GoTouchGra55/Phaze/README.md

# Phaze
A field-oriented control board designed to be used with a brushless motor.

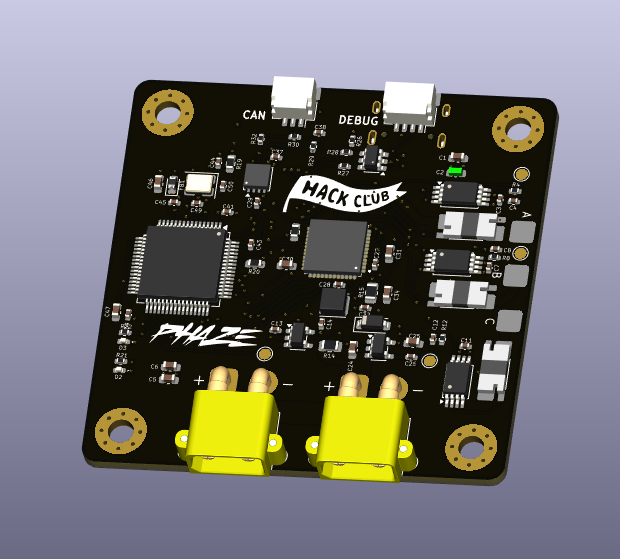
[picture p1: Assets/PCB.png]
PCB


## Overview
Phaze is my attempt at making a custom FOC driver. It utilizes the CAN protocol for communication between a main board and the driver, but it can also be programmed directly via an STLink-V2 debugger. 

The main goal of this project was to explore the hardware side of field-oriented control, especially the design of a dedicated motor driver and the electronics required to control a bldc motor. I wanted to design my own board and understand how all the different sections work together, rather than relying on any existing motor controllers.

## Design
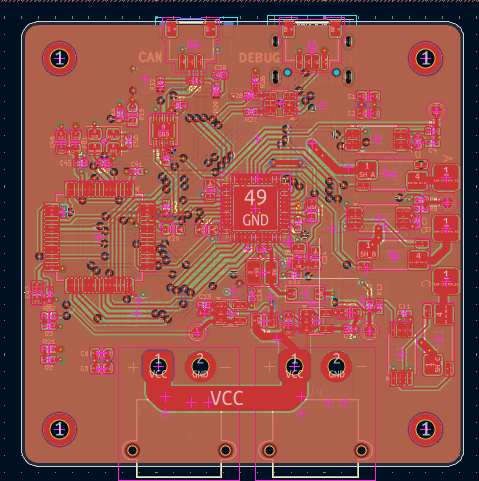
[picture p2: Assets/Routing.png]
Routing
 
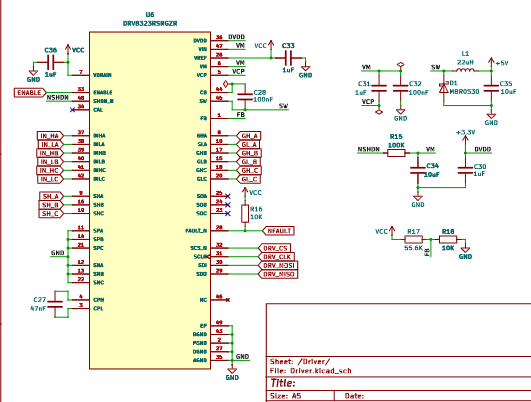
[picture p3: Assets/SCH.png]
Schematics
    
SEE [SCHEMATICS](KiCAD/Phaze.pdf)

## Build Instructions
1. Order the PCB using the provided [files](KiCAD/production).
2. Solder all SMD components according to the schematic and PCB layout.
3. Inspect all solder joints and check for shorts.
4. Connect the peripherals according to the schematic.
5. Flash the firmware and verify all interfaces.
6. Test the power rails before connecting the motors.

## IMPORTANT
1. Use a 3-4s LiPo battery if you decide to use this board in your project. Discard the battery if it smells "funny".

2. Check for any damage on the pcb as it can be the reason for a catastrophic failure.

## Bill Of Materials
| # | Component / Item | Specifications | Qty. | Price (USD) | Link |
|---:|---|---|---:|---:|---:|
| 1 | SMD Resistor Assortment | 660 pcs, mixed packages and values | 1  | $0 | [Daraz](https://www.daraz.com.np/products/000000pcs-040222-10hm-910k-ohm-5-80llasex-cp0pcs-u003d-4000pcs-i416649373-s1793309546.html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) |
| 2 | SMD Ceramic Capacitor Assortment | 2,500 pcs, 50 values, mixed packages | 1  | $0 | [Daraz](https://www.daraz.com.np/products/2500pcs-50-values-capacitor-smd-0402-0603-0805-smd-ceramic-capacitors-assortment-kit-1p-10uf-1pf-5pf-10pf-100pf-1nf-102-333-474-i15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) |
| 3 | JLCPCB PCB Fabrication & Assembly | PCB manufacturing and assembly order | 1 order | $241.02 | [JLCPCB](https://jlcpcb.com)
| | **GRAND TOTAL** | | | **$241.02** | |

## License
### MIT License - See [LICENSE](LICENSE)

## Author
### Shaurya Tamang  
Contact: [Email](shauryatamang.dev@gmail.com)
