GoTouchGra55/Phaze/Assets/JLCPCB.png

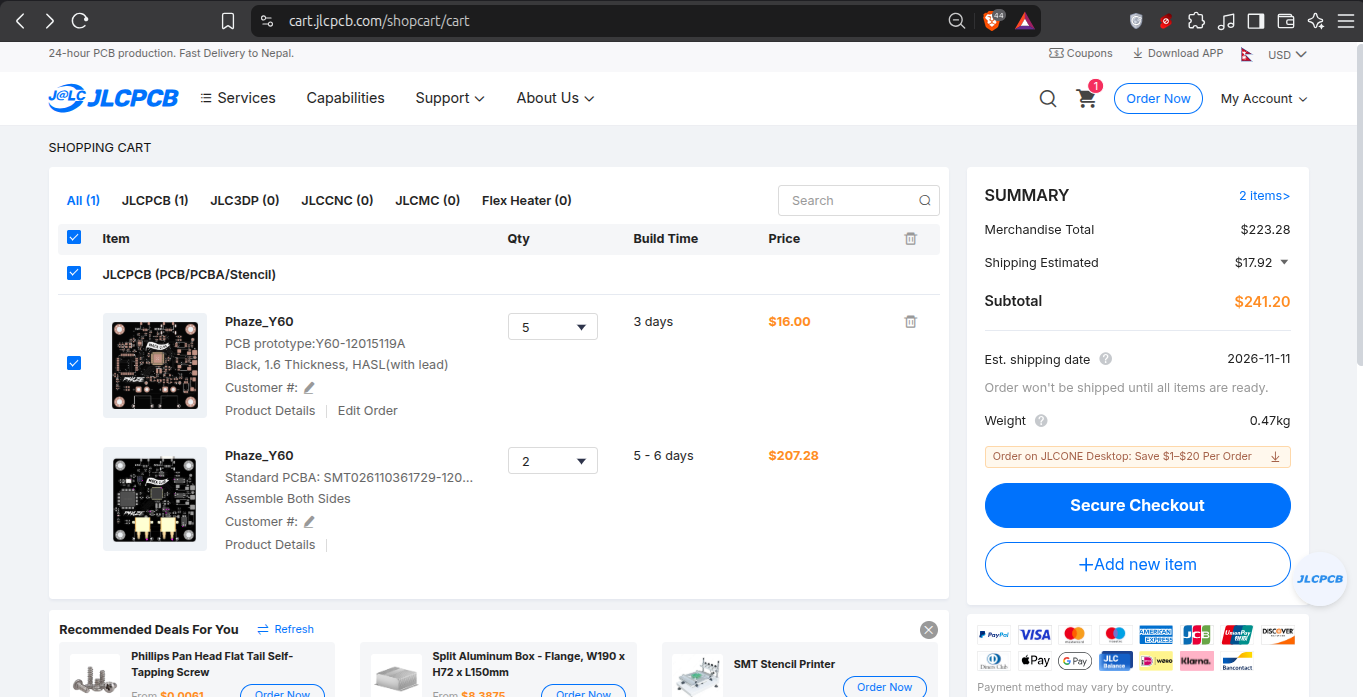
Assets/JLCPCB.png
