GoTouchGra55/Phaze/KiCAD/production/bom.csv

Designator | Footprint | Quantity | Value | LCSC Part #
C1, C10, C15, C16, C17, C18, C19, C2, C20, C21, C22, C34, C35, C5, C6, C9 | 0603 | 16 | 10uF
C11, C13, C14, C23, C28, C29, C3, C32, C37, C39, C40, C41, C42, C43, C51, C7 | 0402 | 16 | 100nF
C12, C4, C8 | 0402 | 3 | 1nF
C24, C30, C31, C33, C36 | 0603 | 5 | 1uF
C25 | 0603 | 1 | 2.2uF
C26 | 0402 | 1 | 10nF
C27 | 0402 | 1 | 47nF
C38 | 0402 | 1 | 4.7nF
C44, C45 | 0402 | 2 | 100nF | C1525
C46 | 0603 | 1 | 1uF | C29266
C47, C48 | 0603 | 2 | 22uF | C1525
C49, C50 | 0402 | 2 | 18pF
D1, D5 | D_SOD-123 | 2 | MBR0530 | C5204746
D2 | 0402 | 1 | RED
D3 | 0402 | 1 | GREEN
FB1 | 0603 | 1 | fcm 1608-0603 | C19330
J1 | CONN_01x01 | 1 | OUT A
J10 | JST_SH_SM06B-SRSS-TB_1x06-1MP_P1.00mm_Horizontal | 1 | Conn_01x06_MountingPin
J2 | CONN_01x01 | 1 | OUT B
J3 | CONN_01x01 | 1 | OUT C
J4, J5 | AMASS_XT30PW-M_1x02_P2.50mm_Horizontal | 2 | Conn_01x02
J6 | JST_SH_SM04B-SRSS-TB_1x04-1MP_P1.00mm_Horizontal | 1 | Conn_01x04_MountingPin
J7 | JST_SH_SM03B-SRSS-TB_1x03-1MP_P1.00mm_Horizontal | 1 | Conn_01x03_MountingPin
J8 | USB_C_Receptacle_GCT_USB4105-xx-A_16P_TopMnt_Horizontal | 1 | USB_C_Receptacle_USB2.0_16P
L1 | L_Cenker_CKCS3015 | 1 | 22uH
Q1, Q2, Q3, Q4, Q5, Q6 | AO_DFN-8-1EP_5.55x5.2mm_P1.27mm_EP4.12x4.6mm | 6 | WSD40120DN56G
R1, R11, R7 | R_Shunt_Vishay_WSK2512_6332Metric_T1.19mm | 3 | 0.01R
R10, R2, R3, R5, R6, R9 | 0402 | 6 | 10R
R12, R21, R22, R4, R8 | 0402 | 5 | 1K
R13 | 0603 | 1 | 2K2
R14 | 0805 | 1 | 39K
R15 | 0805 | 1 | 100K
R16, R18 | 0603 | 2 | 10K
R17 | 0805 | 1 | 55.6K
R19, R20 | 0603 | 2 | 10k | C60490
R26 | 0402 | 1 | 1k8 | C163481
R27, R28 | 0402 | 2 | 100R | C705627
R29, R32 | 0402 | 2 | 30R | C852718
R30 | 0402 | 1 | 120R | C125925
TP1, TP2, TP3, TP4 | TestPoint_Pad_D1.5mm | 4 | TestPoint
U1, U2, U3 | TSSOP-8_4.4x3mm_P0.65mm | 3 | INA240A1PW
U10 | LQFP-64_10x10mm_P0.5mm | 1 | STM32F405RGTx
U4 | SOT-23-5 | 1 | LM321
U5 | TSSOP-14_4.4x5mm_P0.65mm | 1 | AS5047D
U6 | QFN50P700X700X100-49N | 1 | DRV8323RSRGZR
U7 | SOT-23-5 | 1 | LP2985-3.3
U8 | HVSON-8-1EP_3x3mm_P0.65mm_EP1.6x2.4mm | 1 | TJA1051TK-3
U9 | SOT-23-6 | 1 | USBLC6-2SC6 | C2827654
Y1 | Crystal_SMD_3225-4Pin_3.2x2.5mm | 1 | 25MHz
