GoTouchGra55/Phaze/KiCAD/Phaze.pdf

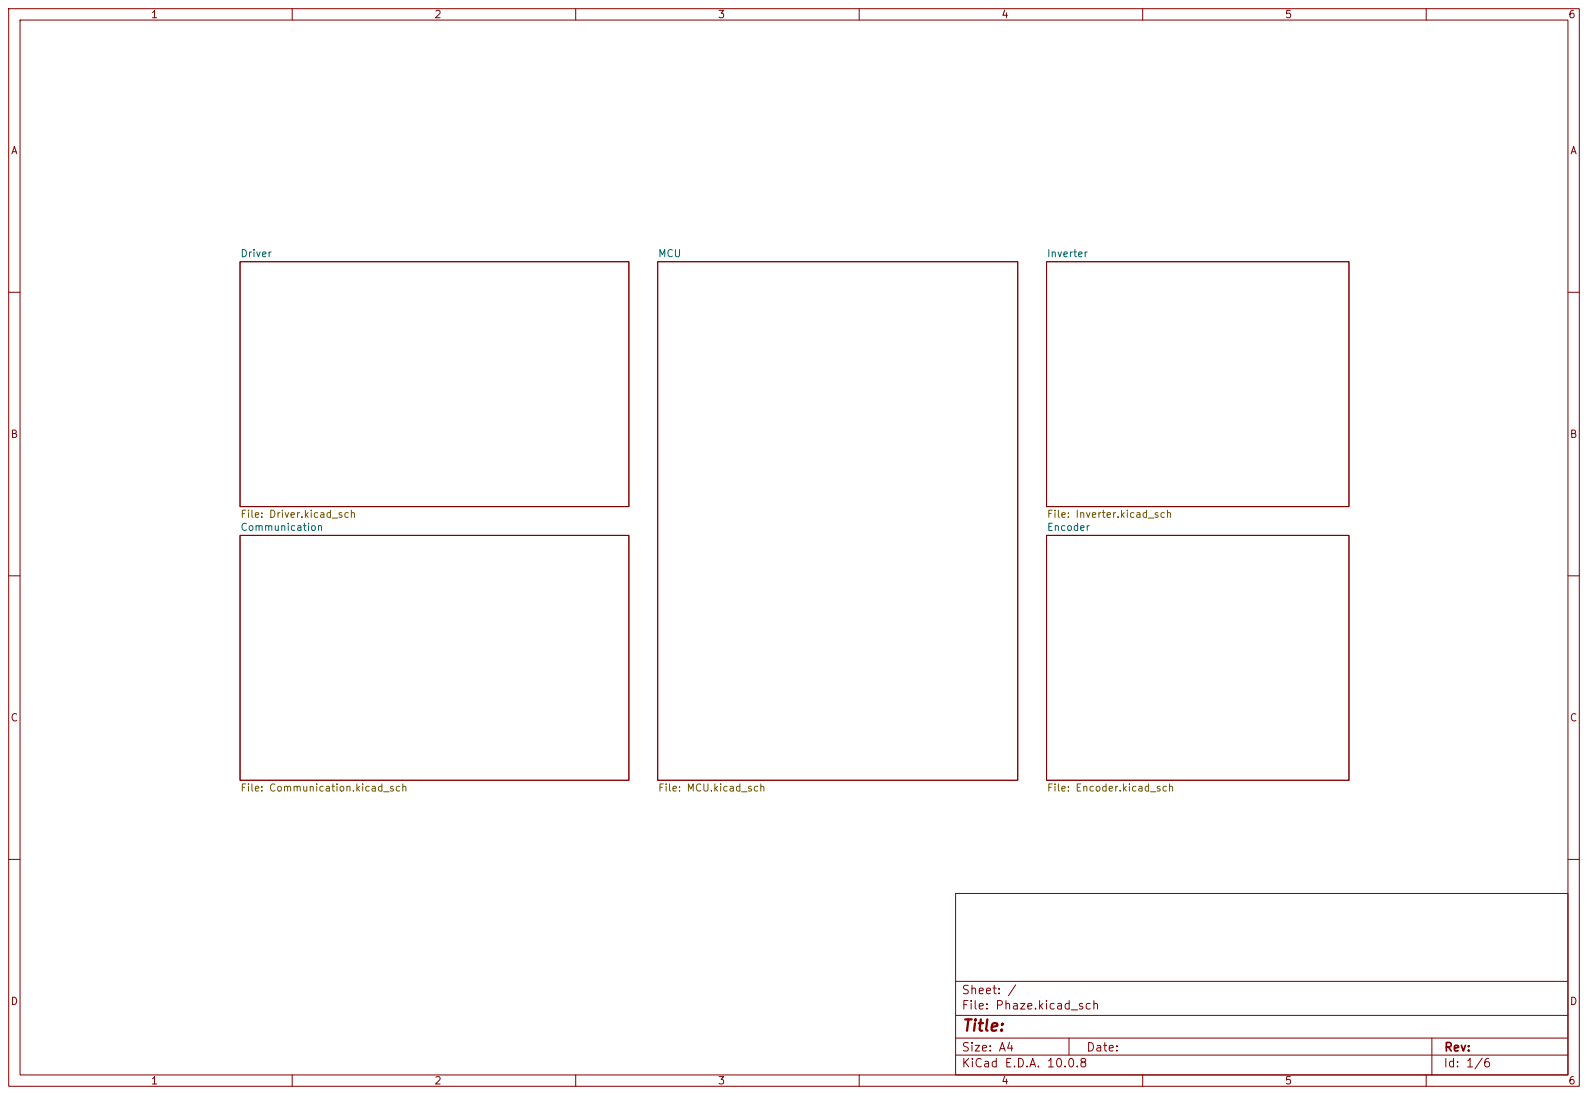
[picture p5: page 1]

Driver File: Driver.kicad_sch Communication

Inverter File: Inverter.kicad_sch MCU

Size: A4 | Rev:
KiCad E.D.A. 10.0.8 | Id: 1/6

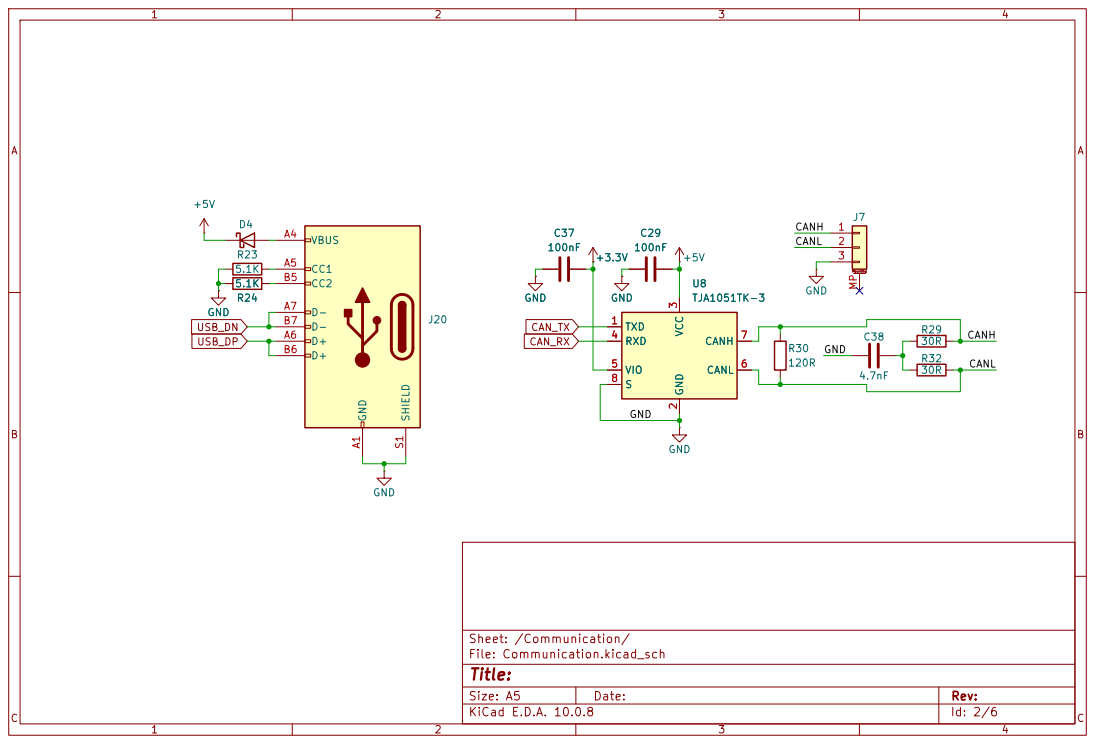
[picture p6: page 2]

Size: A5 | Rev: | C Date:
KiCad E.D.A. 10.0.8 | Id: 2/6

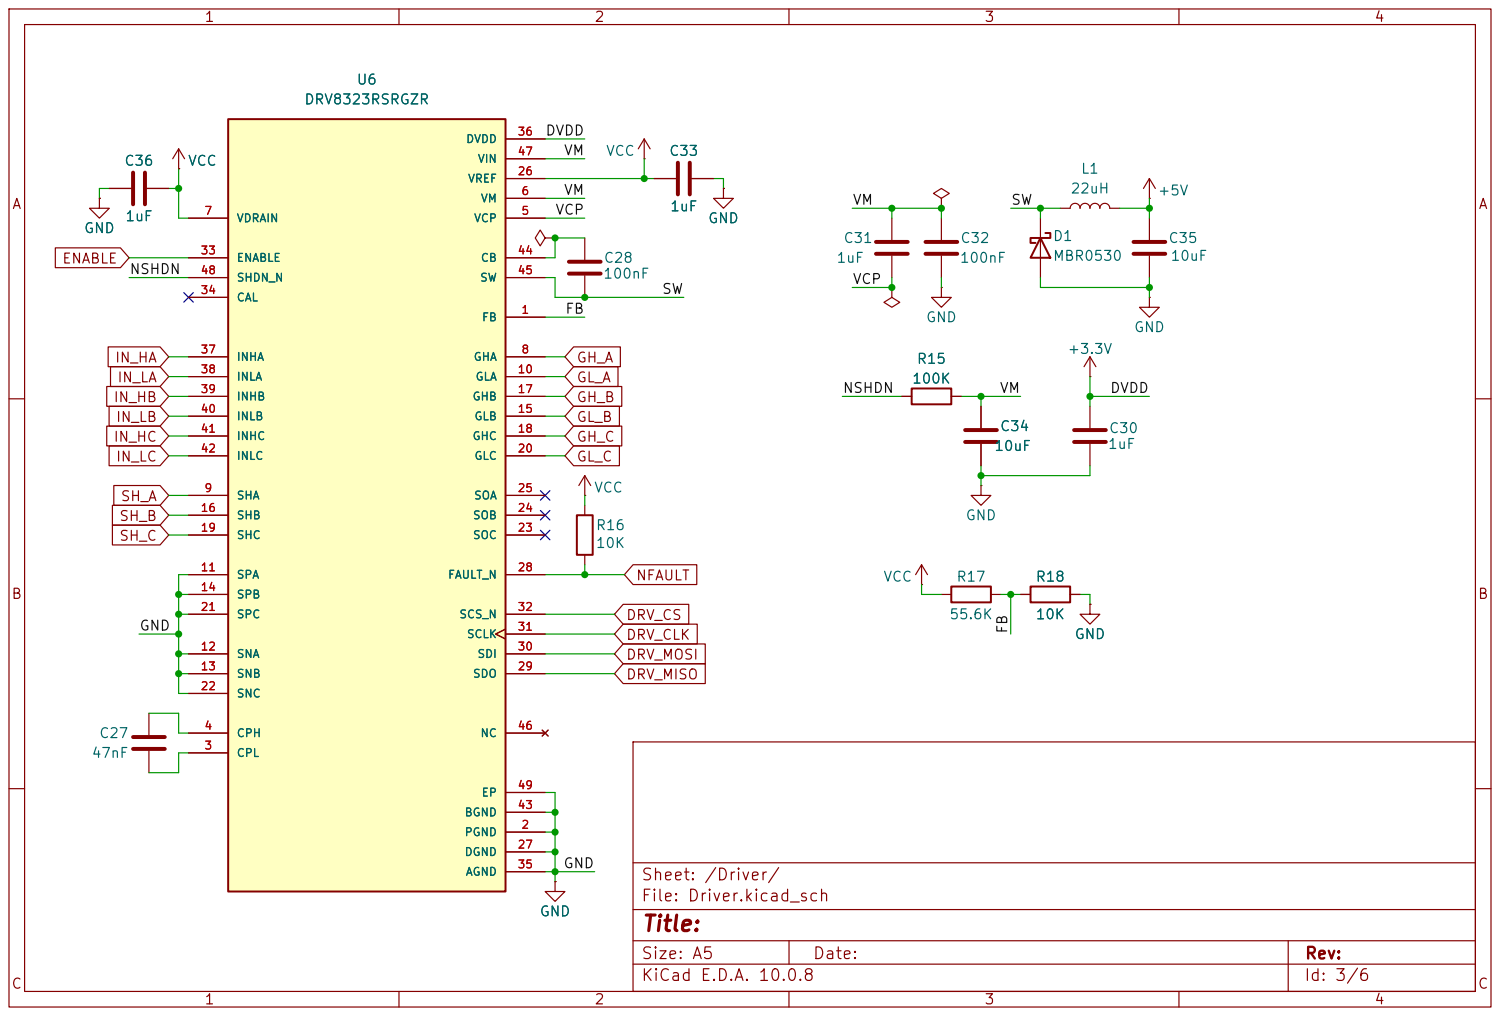
[picture p7: page 3]

Size: A5 | Rev: | C Date:
KiCad E.D.A. 10.0.8 | Id: 3/6

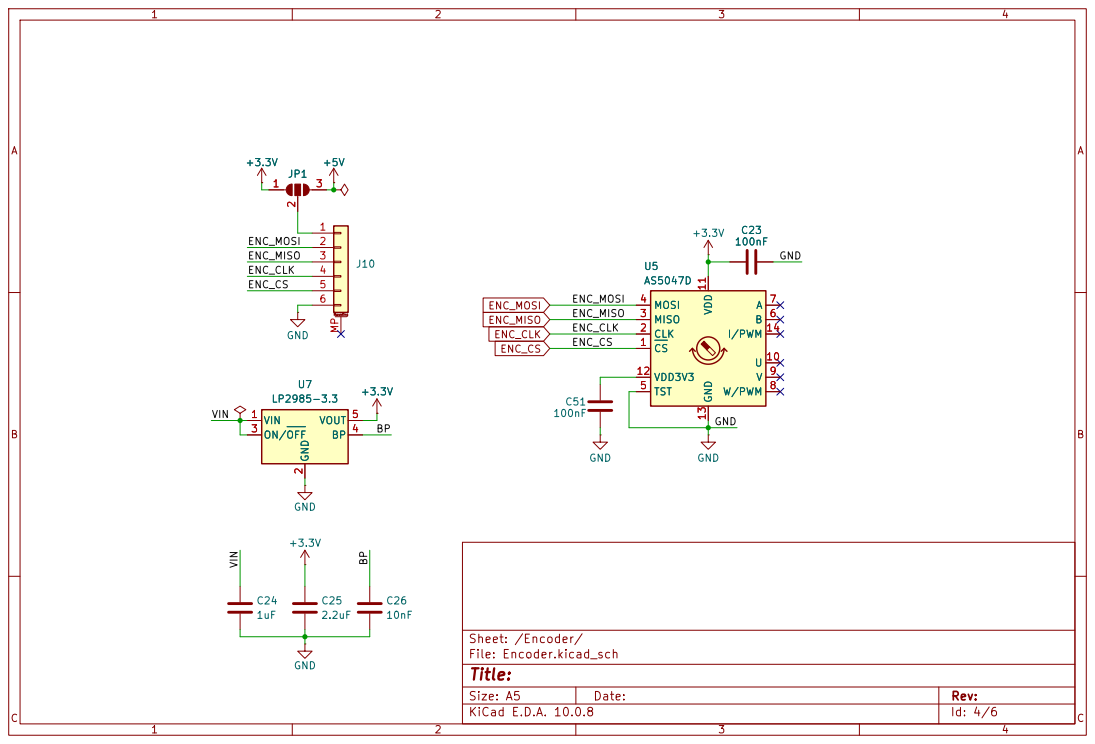
[picture p8: page 4]

Size: A5 | Rev:
KiCad E.D.A. 10.0.8 | Id: 4/6

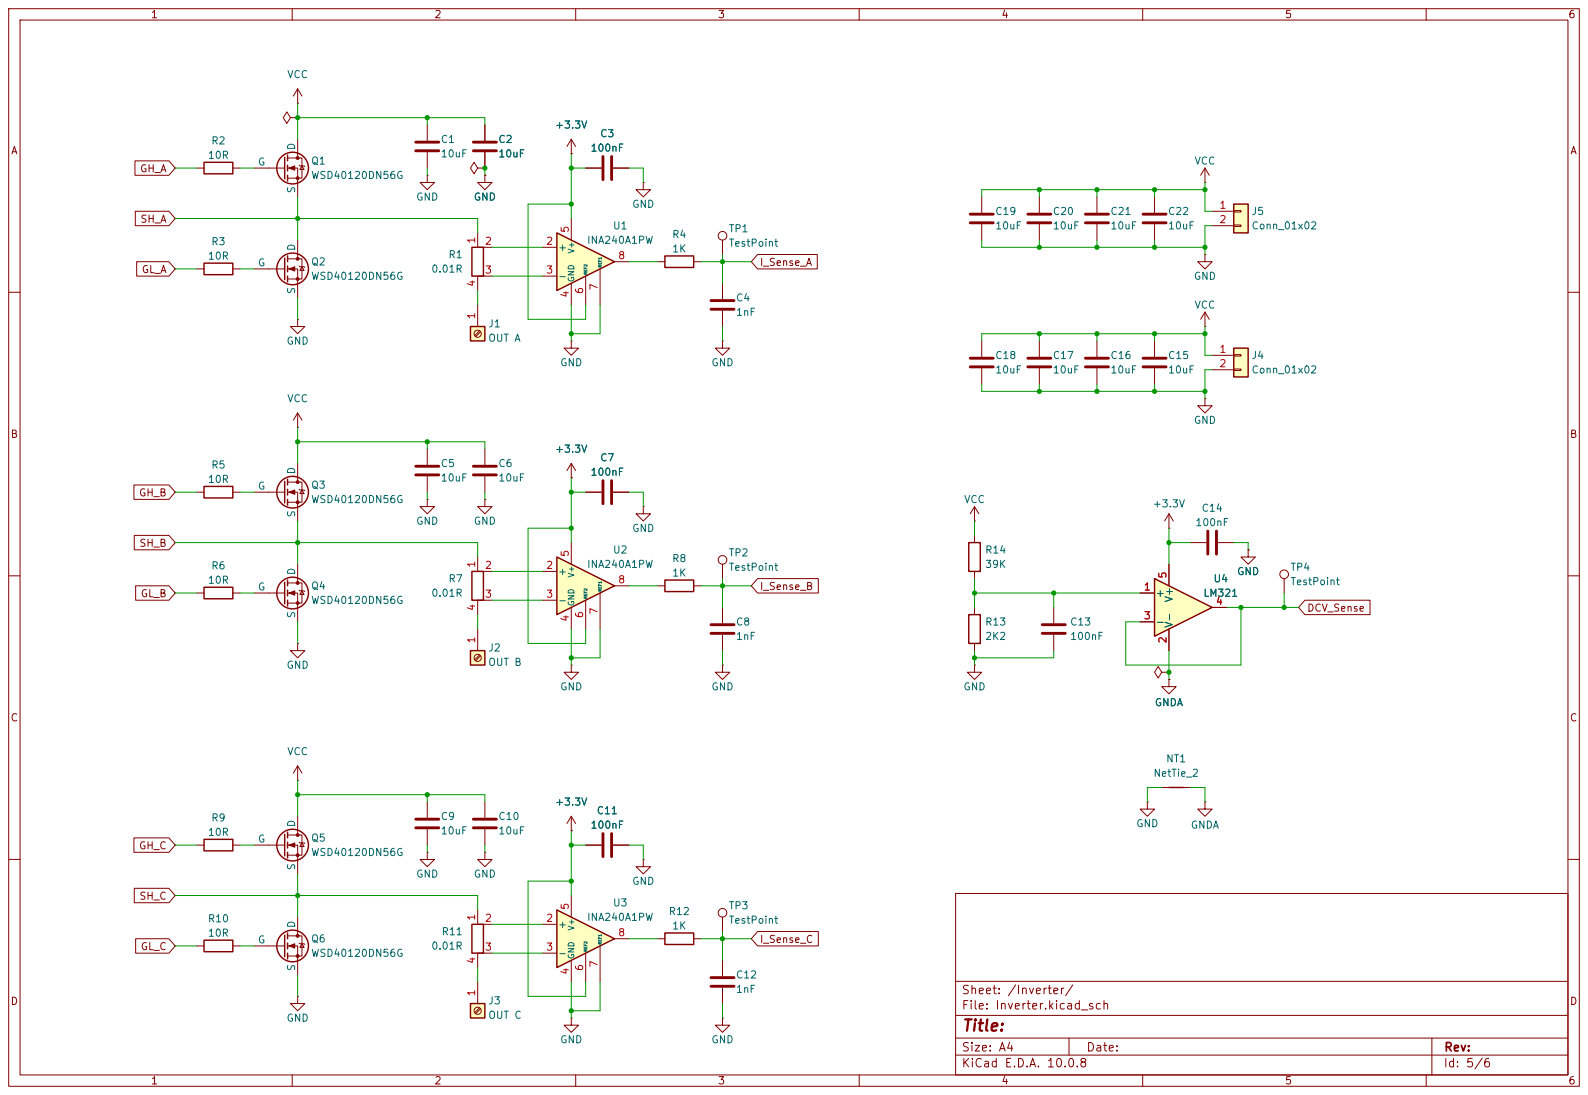
[picture p9: page 5]

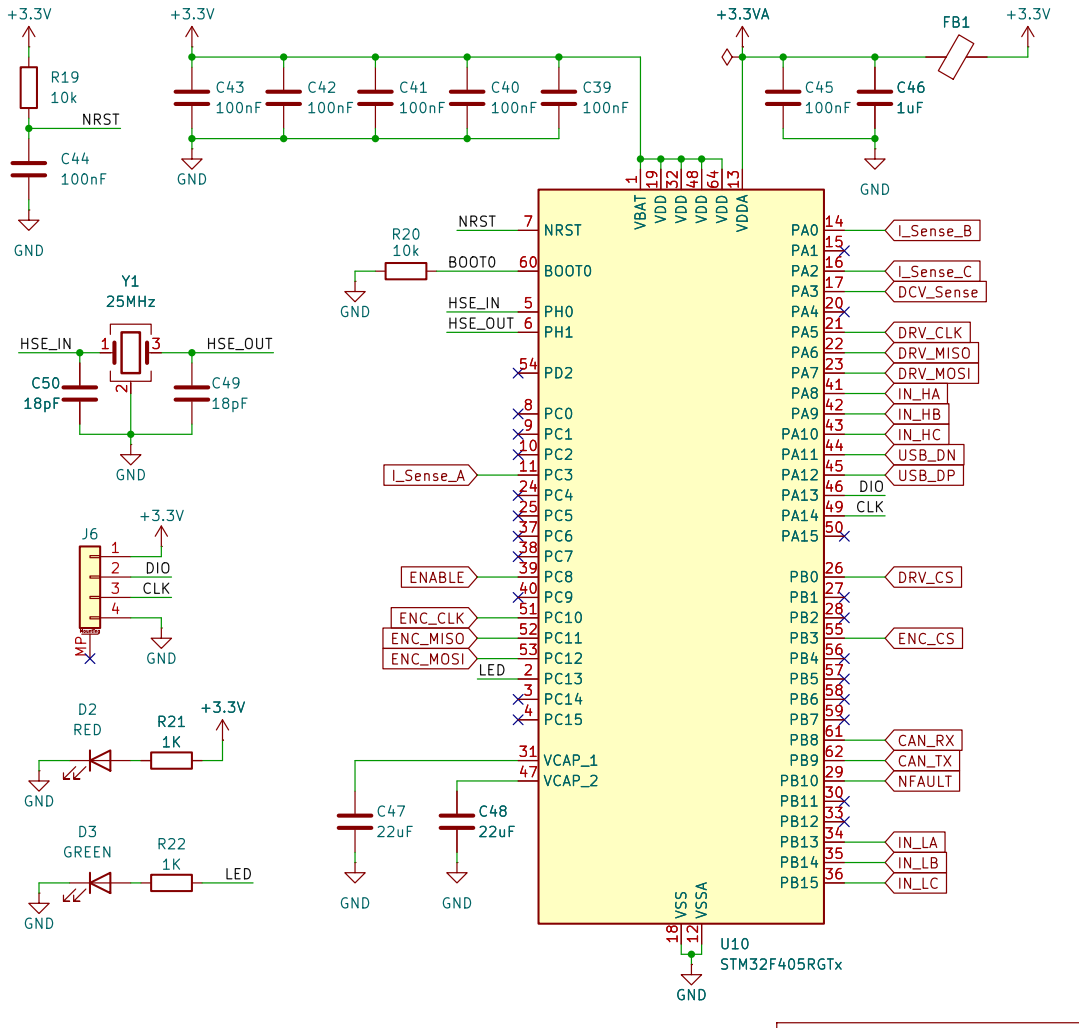
[picture p10: page 6]
