GoTouchGra55/Phaze/KiCAD/Phaze.kicad_pcb

## KiCad design KiCAD/Phaze.kicad_pcb (2026-11-03)

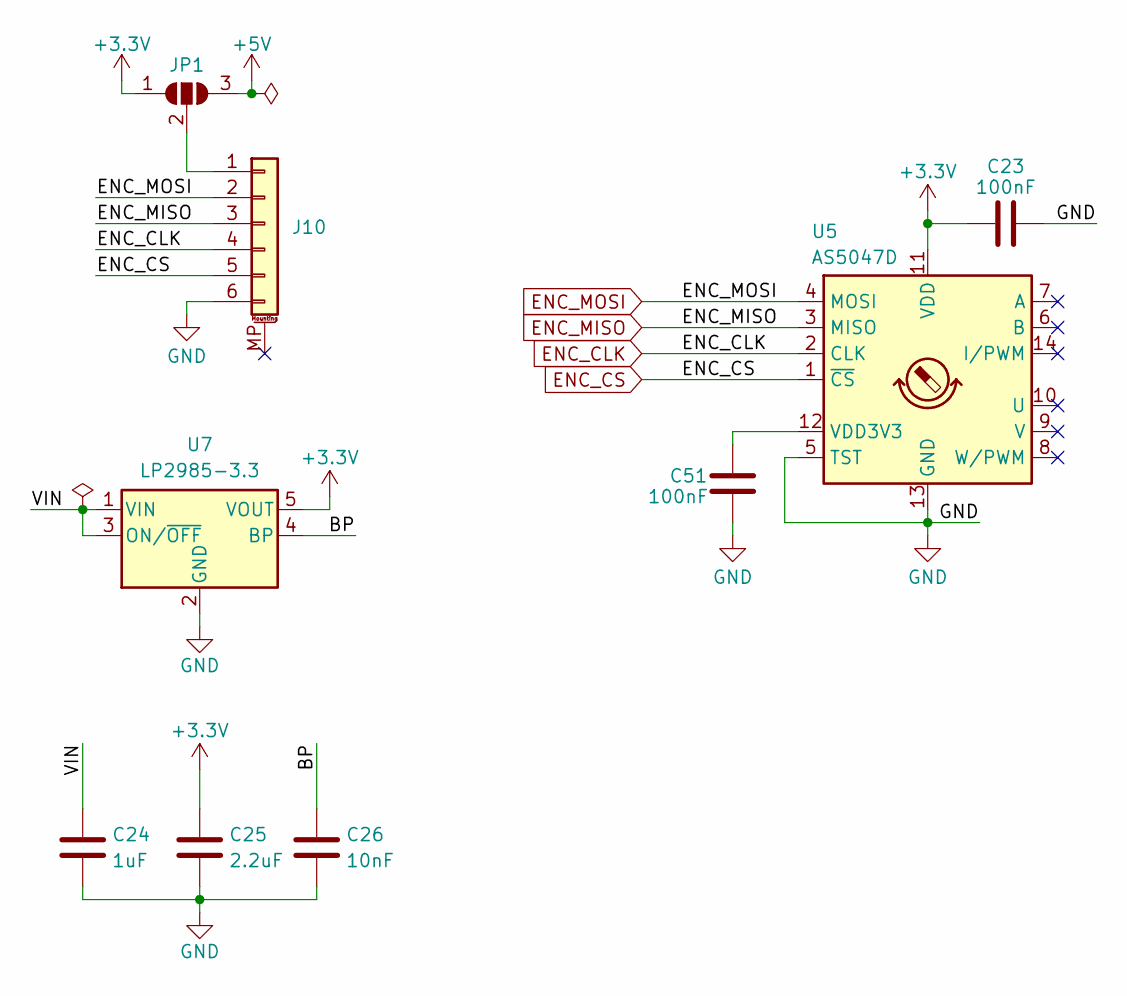
[picture p11: schematic Encoder.kicad_sch]

Parts:
C23, C51: 100nF; C_0402_1005Metric
C24: 1uF; C_0603_1608Metric
C25: 2.2uF; C_0603_1608Metric
C26: 10nF; C_0402_1005Metric
J10: Conn_01x06_MountingPin; JST_SH_SM06B-SRSS-TB_1x06-1MP_P1.00mm_Horizontal
JP1: SolderJumper_3_Open; SolderJumper-3_P1.3mm_Open_Pad1.0x1.5mm_NumberLabels
U5: AS5047D; TSSOP-14_4.4x5mm_P0.65mm
U7: LP2985-3.3; SOT-23-5

Connections:
+3.3V: C23.1, C25.1, JP1.1 (A), U5.11 (VDD), U7.5 (VOUT); also elsewhere on the board
+5V: JP1.3 (B); also elsewhere on the board
/Encoder/BP: C26.1, U7.4 (BP)
ENC_CLK: J10.4, U5.2 (CLK); also elsewhere on the board
ENC_CS: J10.5, U5.1 (~CS); also elsewhere on the board
ENC_MISO: J10.3, U5.3 (MISO); also elsewhere on the board
ENC_MOSI: J10.2, U5.4 (MOSI); also elsewhere on the board
GND: C23.2, C24.2, C25.2, C26.2, C51.1, J10.6, U5.5 (TST), U5.13 (GND), U7.2 (GND); also elsewhere on the board
unnamed: J10.1, JP1.2 (C)
unnamed: C51.2, U5.12 (VDD3V3)
VCC: C24.1, U7.1 (VIN), U7.3 (ON/~OFF); also elsewhere on the board

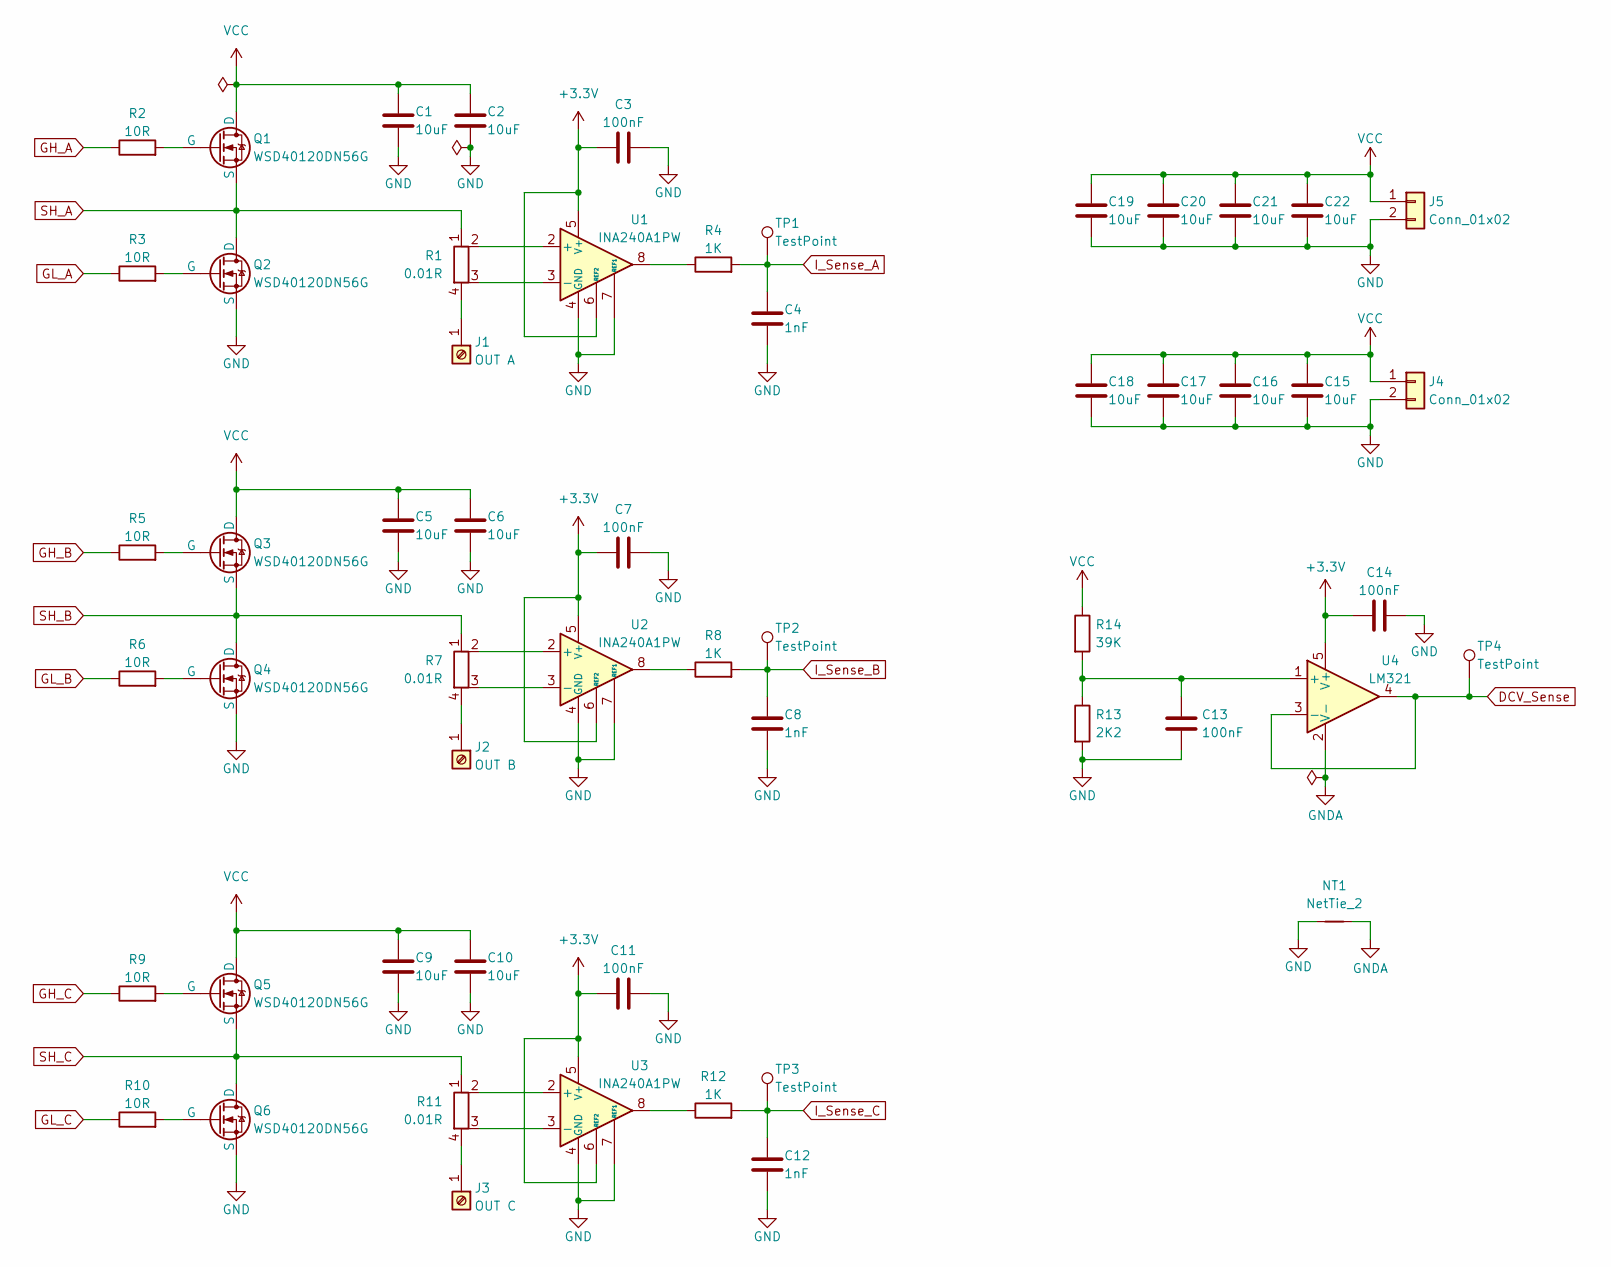
[picture p12: schematic Inverter.kicad_sch]

Parts:
C1, C2, C5, C6, C9, C10, C15, C16, C17, C18, C19, C20, C21, C22: 10uF; C_0603_1608Metric
C3, C7, C11, C13, C14: 100nF; C_0402_1005Metric
C4, C8, C12: 1nF; C_0402_1005Metric
J1: OUT A; CONN_01x01
J2: OUT B; CONN_01x01
J3: OUT C; CONN_01x01
J4, J5: Conn_01x02; AMASS_XT60PW-M_1x02_P7.20mm_Horizontal
NT1: NetTie_2; NetTie-2_SMD_Pad0.5mm
Q1, Q2, Q3, Q4, Q5, Q6: WSD40120DN56G; AO_DFN-8-1EP_5.55x5.2mm_P1.27mm_EP4.12x4.6mm
R1, R7, R11: 0.01R; R_Shunt_Vishay_WSK2512_6332Metric_T1.19mm
R2, R3, R5, R6, R9, R10: 10R; R_0402_1005Metric
R4, R8, R12: 1K; R_0402_1005Metric
R13: 2K2; R_0603_1608Metric
R14: 39K; R_0805_2012Metric
TP1, TP2, TP3, TP4: TestPoint; TestPoint_Pad_D1.5mm
U1, U2, U3: INA240A1PW; TSSOP-8_4.4x3mm_P0.65mm
U4: LM321; SOT-23-5

Connections:
+3.3V: C3.1, C7.1, C11.1, C14.1, U1.5 (V+), U1.6 (REF2), U2.5 (V+), U2.6 (REF2), U3.5 (V+), U3.6 (REF2), U4.5 (V+); also elsewhere on the board
DCV_Sense: TP4.1 (1_1), U4.3 (-), U4.4; also elsewhere on the board
GH_A: R2.1; also elsewhere on the board
GH_B: R5.1; also elsewhere on the board
GH_C: R9.1; also elsewhere on the board
GL_A: R3.1; also elsewhere on the board
GL_B: R6.1; also elsewhere on the board
GL_C: R10.1; also elsewhere on the board
GND: C1.2, C2.2, C3.2, C4.2, C5.2, C6.2, C7.2, C8.2, C9.2, C10.2, C11.2, C12.2, C13.2, C14.2, C15.2, C16.2, C17.2, C18.2, C19.2, C20.2, C21.2, C22.2, J4.2, J5.2, NT1.1, Q2.3 (S), Q4.3 (S), Q6.3 (S), R13.2, U1.1 (GND), U1.4 (GND), U1.7 (REF1), U2.1 (GND), U2.4 (GND), U2.7 (REF1), U3.1 (GND), U3.4 (GND), U3.7 (REF1); also elsewhere on the board
GNDA: NT1.2, U4.2 (V-)
I_Sense_A: C4.1, R4.2, TP1.1 (1_1); also elsewhere on the board
I_Sense_B: C8.1, R8.2, TP2.1 (1_1); also elsewhere on the board
I_Sense_C: C12.1, R12.2, TP3.1 (1_1); also elsewhere on the board
unnamed: J1.1 (Pin_1_1), R1.4
unnamed: J2.1 (Pin_1_1), R7.4
unnamed: J3.1 (Pin_1_1), R11.4
unnamed: Q1.2 (G), R2.2
unnamed: Q2.2 (G), R3.2
unnamed: Q3.2 (G), R5.2
unnamed: Q4.2 (G), R6.2
unnamed: Q5.2 (G), R9.2
unnamed: Q6.2 (G), R10.2
unnamed: R4.1, U1.8
unnamed: R8.1, U2.8
unnamed: R12.1, U3.8
unnamed: R1.2, U1.2 (+)
unnamed: R1.3, U1.3 (-)
unnamed: R7.2, U2.2 (+)
unnamed: R7.3, U2.3 (-)
unnamed: R11.2, U3.2 (+)
unnamed: R11.3, U3.3 (-)
unnamed: C13.1, R13.1, R14.2, U4.1 (+)
SH_A: Q1.3 (S), Q2.1 (D), R1.1; also elsewhere on the board
SH_B: Q3.3 (S), Q4.1 (D), R7.1; also elsewhere on the board
SH_C: Q5.3 (S), Q6.1 (D), R11.1; also elsewhere on the board
VCC: C1.1, C2.1, C5.1, C6.1, C9.1, C10.1, C15.1, C16.1, C17.1, C18.1, C19.1, C20.1, C21.1, C22.1, J4.1, J5.1, Q1.1 (D), Q3.1 (D), Q5.1 (D), R14.1; also elsewhere on the board

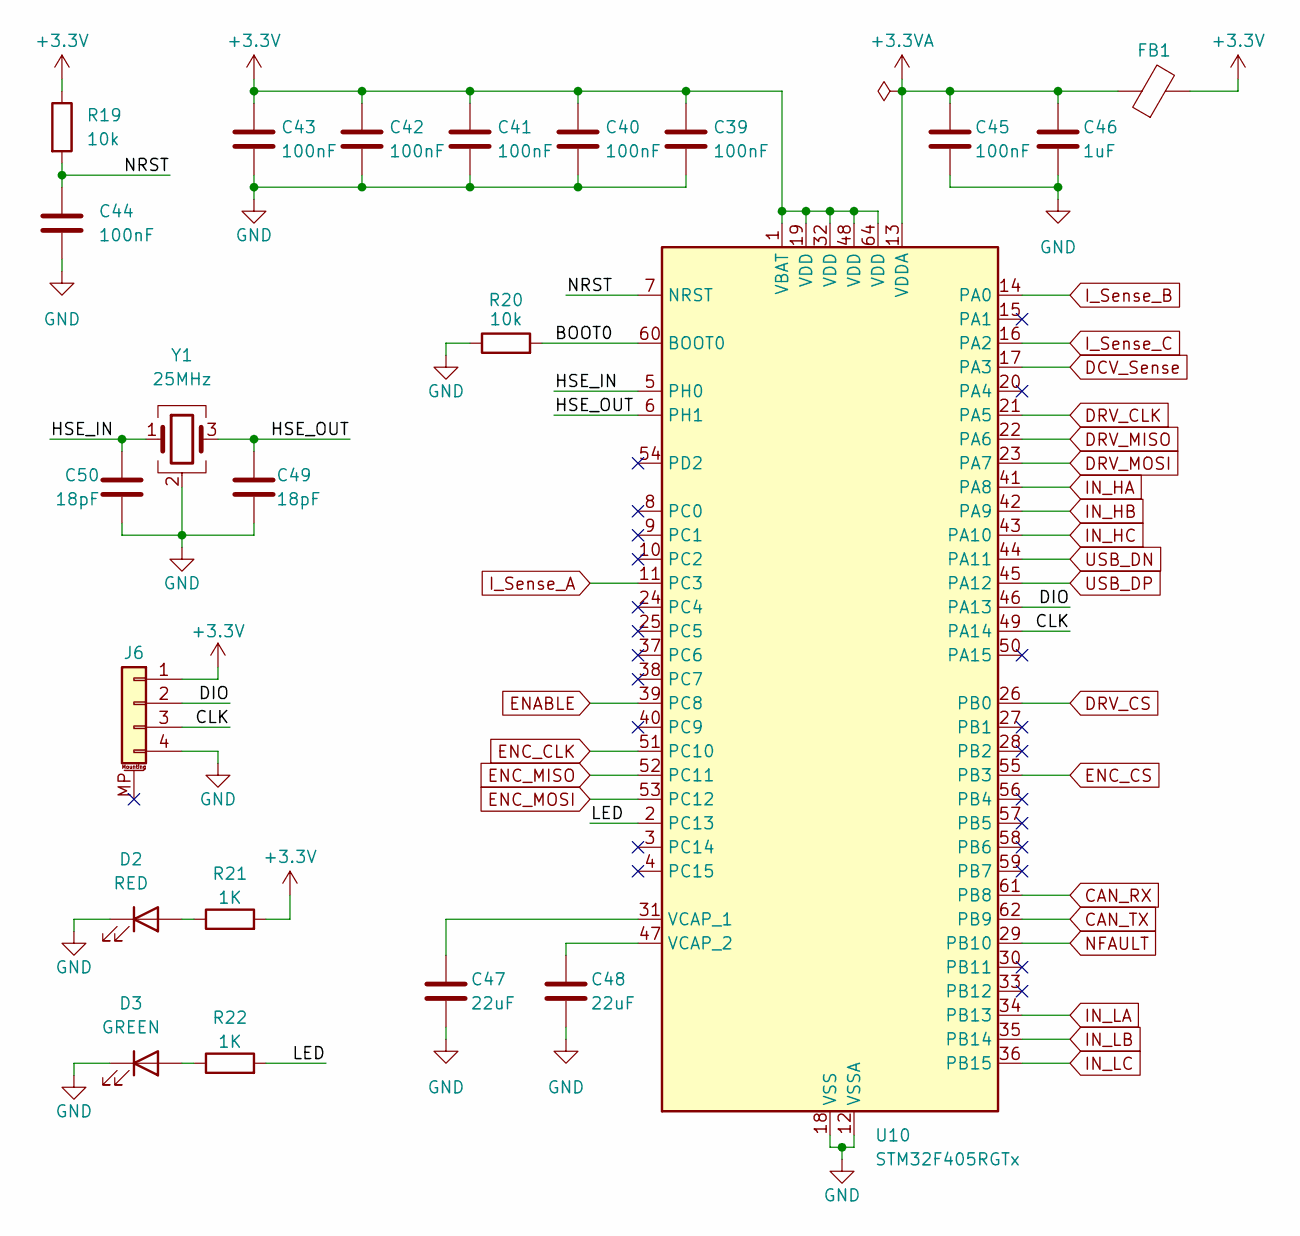
[picture p13: schematic MCU.kicad_sch]

Parts:
C39, C40, C41, C42, C43: 100nF; C_0402_1005Metric
C44, C45: 100nF; C_0402_1005Metric; LCSC Part # C1525
C46: 1uF; C_0603_1608Metric; LCSC Part # C29266
C47, C48: 22uF; C_0603_1608Metric; LCSC Part # C1525
C49, C50: 18pF; C_0402_1005Metric
D2: RED; LED_0402_1005Metric
D3: GREEN; LED_0402_1005Metric
FB1: fcm 1608-0603; D_0603_1608Metric; LCSC Part # C19330
J6: Conn_01x04_MountingPin; JST_SH_SM04B-SRSS-TB_1x04-1MP_P1.00mm_Horizontal
R19, R20: 10k; R_0603_1608Metric; LCSC Part # C60490
R21, R22: 1K; R_0402_1005Metric
U10: STM32F405RGTx; LQFP-64_10x10mm_P0.5mm
Y1: 25MHz; Crystal_SMD_3225-4Pin_3.2x2.5mm

Connections:
+3.3V: C39.1, C40.1, C41.1, C42.1, C43.1, FB1.2, J6.1, R19.1, R21.2, U10.1 (VBAT), U10.19 (VDD), U10.32 (VDD), U10.48 (VDD), U10.64 (VDD); also elsewhere on the board
+3.3VA: C45.1, C46.1, FB1.1, U10.13 (VDDA)
/MCU/BOOT0: R20.2, U10.60 (BOOT0)
/MCU/CLK: J6.3, U10.49 (PA14)
/MCU/DIO: J6.2, U10.46 (PA13)
/MCU/HSE_IN: C50.1, U10.5 (PH0), Y1.1
/MCU/HSE_OUT: C49.1, U10.6 (PH1), Y1.3
/MCU/LED: R22.2, U10.2 (PC13)
/MCU/NRST: C44.1, R19.2, U10.7 (NRST)
CAN_RX: U10.61 (PB8); also elsewhere on the board
CAN_TX: U10.62 (PB9); also elsewhere on the board
DCV_Sense: U10.17 (PA3); also elsewhere on the board
DRV_CLK: U10.21 (PA5); also elsewhere on the board
DRV_CS: U10.26 (PB0); also elsewhere on the board
DRV_MISO: U10.22 (PA6); also elsewhere on the board
DRV_MOSI: U10.23 (PA7); also elsewhere on the board
ENABLE: U10.39 (PC8); also elsewhere on the board
ENC_CLK: U10.51 (PC10); also elsewhere on the board
ENC_CS: U10.55 (PB3); also elsewhere on the board
ENC_MISO: U10.52 (PC11); also elsewhere on the board
ENC_MOSI: U10.53 (PC12); also elsewhere on the board
GND: C39.2, C40.2, C41.2, C42.2, C43.2, C44.2, C45.2, C46.2, C47.2, C48.2, C49.2, C50.2, D2.1 (K), D3.1 (K), J6.4, R20.1, U10.12 (VSSA), U10.18 (VSS), U10.63 (VSS), Y1.2 (G), Y1.4 (G); also elsewhere on the board
IN_HA: U10.41 (PA8); also elsewhere on the board
IN_HB: U10.42 (PA9); also elsewhere on the board
IN_HC: U10.43 (PA10); also elsewhere on the board
IN_LA: U10.34 (PB13); also elsewhere on the board
IN_LB: U10.35 (PB14); also elsewhere on the board
IN_LC: U10.36 (PB15); also elsewhere on the board
I_Sense_A: U10.11 (PC3); also elsewhere on the board
I_Sense_B: U10.14 (PA0); also elsewhere on the board
I_Sense_C: U10.16 (PA2); also elsewhere on the board
NFAULT: U10.29 (PB10); also elsewhere on the board
unnamed: D2.2 (A), R21.1
unnamed: D3.2 (A), R22.1
unnamed: C47.1, U10.31 (VCAP_1)
unnamed: C48.1, U10.47 (VCAP_2)
USB_DN: U10.44 (PA11); also elsewhere on the board
USB_DP: U10.45 (PA12); also elsewhere on the board

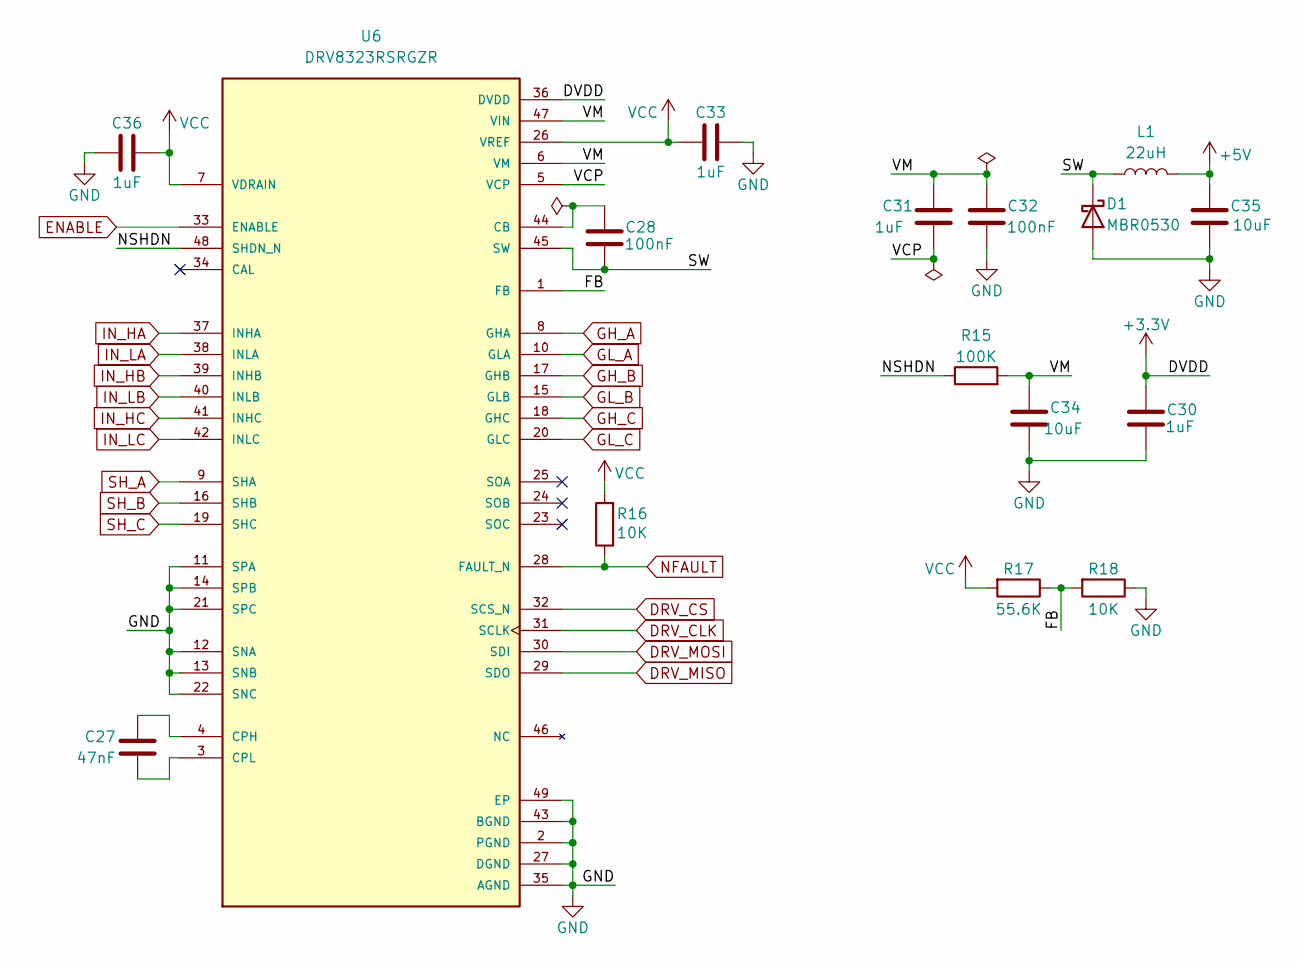
[picture p14: schematic Driver.kicad_sch]

Parts:
C27: 47nF; C_0402_1005Metric
C28, C32: 100nF; C_0402_1005Metric
C30, C31, C33, C36: 1uF; C_0603_1608Metric
C34, C35: 10uF; C_0603_1608Metric
D1: MBR0530; D_SOD-123; LCSC Part # C5204746
L1: 22uH; L_Cenker_CKCS3015
R15: 100K; R_0805_2012Metric
R16, R18: 10K; R_0603_1608Metric
R17: 55.6K; R_0805_2012Metric
U6: DRV8323RSRGZR; QFN50P700X700X100-49N; PARTREV C

Connections:
+3.3V: C30.1, U6.36 (DVDD); also elsewhere on the board
+5V: C35.2, L1.2; also elsewhere on the board
/Driver/FB: R17.1, R18.2, U6.1 (FB)
/Driver/NSHDN: R15.1, U6.48 (SHDN_N)
/Driver/SW: C28.1, D1.1 (K), L1.1, U6.45 (SW)
/Driver/VCP: C31.1, U6.5 (VCP)
/Driver/VM: C31.2, C32.2, C34.2, R15.2, U6.6 (VM), U6.47 (VIN)
DRV_CLK: U6.31 (SCLK); also elsewhere on the board
DRV_CS: U6.32 (SCS_N); also elsewhere on the board
DRV_MISO: U6.29 (SDO); also elsewhere on the board
DRV_MOSI: U6.30 (SDI); also elsewhere on the board
ENABLE: U6.33 (ENABLE); also elsewhere on the board
GH_A: U6.8 (GHA); also elsewhere on the board
GH_B: U6.17 (GHB); also elsewhere on the board
GH_C: U6.18 (GHC); also elsewhere on the board
GL_A: U6.10 (GLA); also elsewhere on the board
GL_B: U6.15 (GLB); also elsewhere on the board
GL_C: U6.20 (GLC); also elsewhere on the board
GND: C30.2, C32.1, C33.2, C34.1, C35.1, C36.2, D1.2 (A), R18.1, U6.2 (PGND), U6.11 (SPA), U6.12 (SNA), U6.13 (SNB), U6.14 (SPB), U6.21 (SPC), U6.22 (SNC), U6.27 (DGND), U6.35 (AGND), U6.43 (BGND), U6.49 (EP); also elsewhere on the board
IN_HA: U6.37 (INHA); also elsewhere on the board
IN_HB: U6.39 (INHB); also elsewhere on the board
IN_HC: U6.41 (INHC); also elsewhere on the board
IN_LA: U6.38 (INLA); also elsewhere on the board
IN_LB: U6.40 (INLB); also elsewhere on the board
IN_LC: U6.42 (INLC); also elsewhere on the board
NFAULT: R16.1, U6.28 (FAULT_N); also elsewhere on the board
unnamed: C28.2, U6.44 (CB)
unnamed: C27.2, U6.4 (CPH)
unnamed: C27.1, U6.3 (CPL)
SH_A: U6.9 (SHA); also elsewhere on the board
SH_B: U6.16 (SHB); also elsewhere on the board
SH_C: U6.19 (SHC); also elsewhere on the board
VCC: C33.1, C36.1, R16.2, R17.2, U6.7 (VDRAIN), U6.26 (VREF); also elsewhere on the board

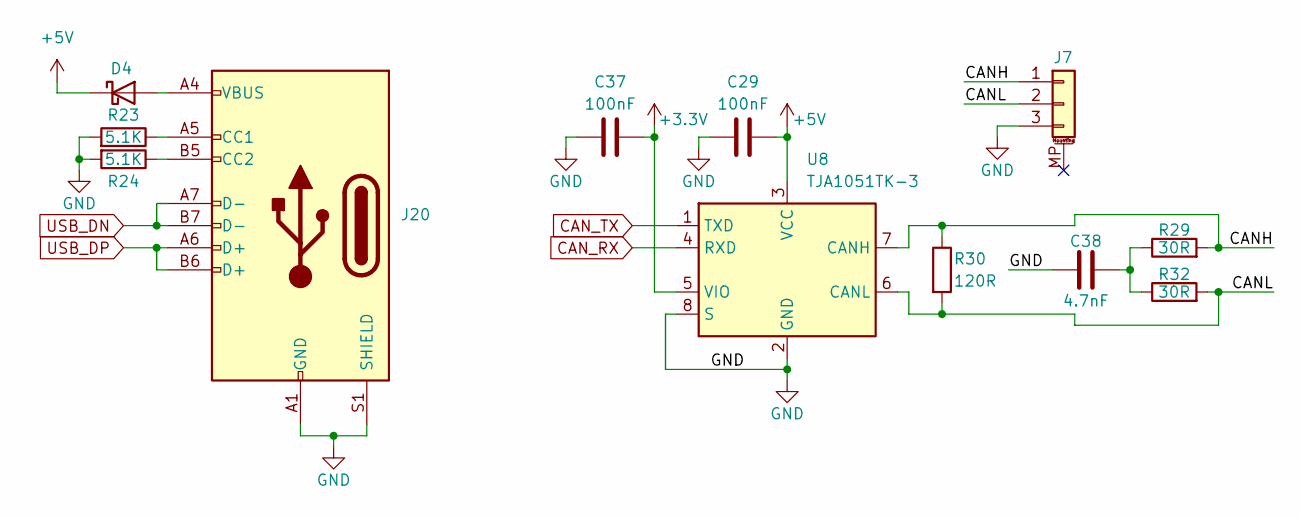
[picture p15: schematic Communication.kicad_sch]

Parts:
C29, C37: 100nF; C_0402_1005Metric
C38: 4.7nF; C_0402_1005Metric
D4: D_Schottky; D_SOD-123
J7: Conn_01x03_MountingPin; JST_SH_SM03B-SRSS-TB_1x03-1MP_P1.00mm_Horizontal
J20: USB_C_Receptacle_USB2.0_14P; USB_C_Receptacle_GCT_USB4105-xx-A_16P_TopMnt_Horizontal
R23, R24: 5.1K; R_0402_1005Metric
R29: 30R; R_0402_1005Metric; LCSC Part # C852718
R30: 120R; R_0402_1005Metric; LCSC Part # C125925
R32: 30R; R_0402_1005Metric_Pad0.72x0.64mm_HandSolder; LCSC Part # C852718
U8: TJA1051TK-3; HVSON-8-1EP_3x3mm_P0.65mm_EP1.6x2.4mm

Connections:
+3.3V: C37.2, U8.5 (VIO); also elsewhere on the board
+5V: C29.2, D4.1 (K), U8.3 (VCC); also elsewhere on the board
/Communication/CANH: J7.1, R29.2, R30.1, U8.7 (CANH)
/Communication/CANL: J7.2, R30.2, R32.2, U8.6 (CANL)
CAN_RX: U8.4 (RXD); also elsewhere on the board
CAN_TX: U8.1 (TXD); also elsewhere on the board
GND: C29.1, C37.1, C38.1, J7.3, J20.A1 (GND), J20.A12 (GND), J20.B1 (GND), J20.B12 (GND), J20.S1 (SHIELD), R23.2, R24.2, U8.2 (GND), U8.8 (S), U8.9 (GND); also elsewhere on the board
unnamed: C38.2, R29.1, R32.1
unnamed: D4.2 (A), J20.A4 (VBUS), J20.A9 (VBUS), J20.B4 (VBUS), J20.B9 (VBUS)
unnamed: J20.A5 (CC1), R23.1
unnamed: J20.A6 (D+), J20.B6 (D+)
unnamed: J20.A7 (D-), J20.B7 (D-)
unnamed: J20.B5 (CC2), R24.1

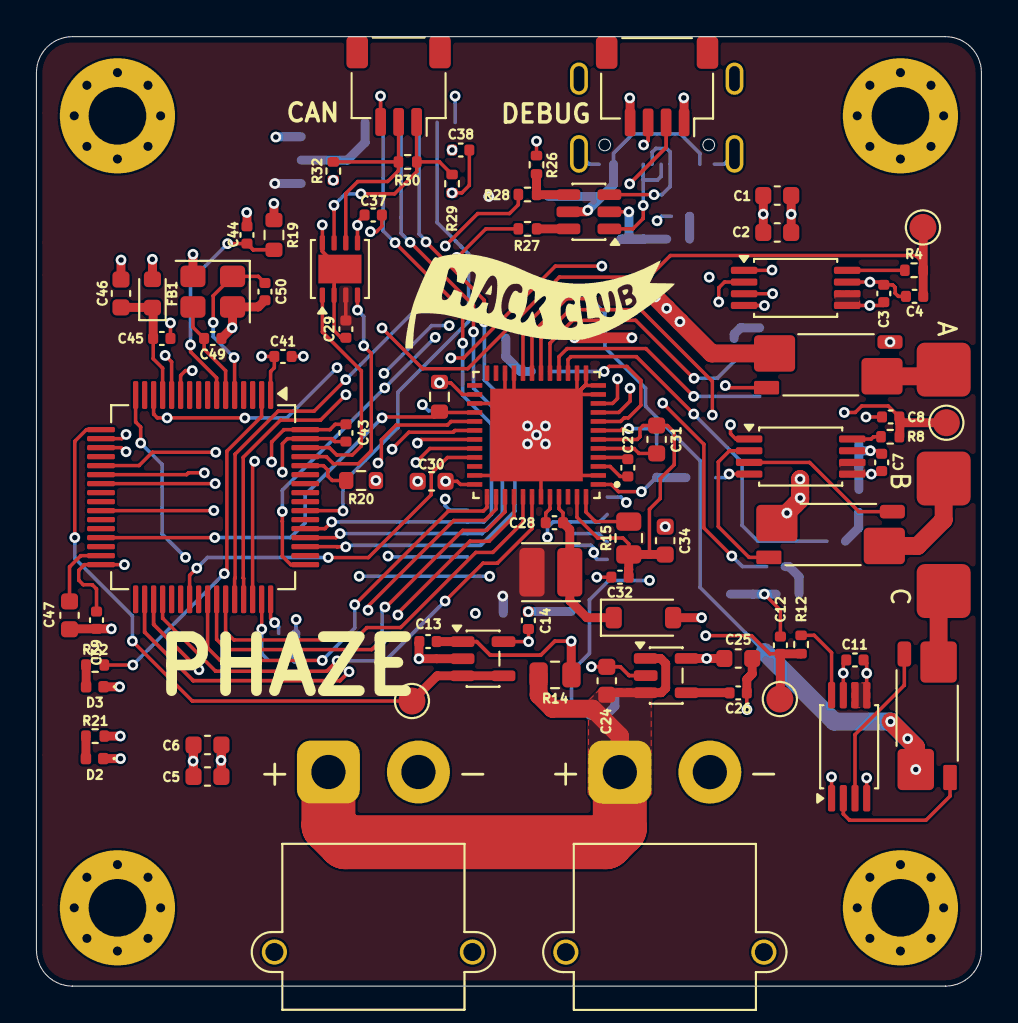
[picture p16: board Phaze.kicad_pcb from above]

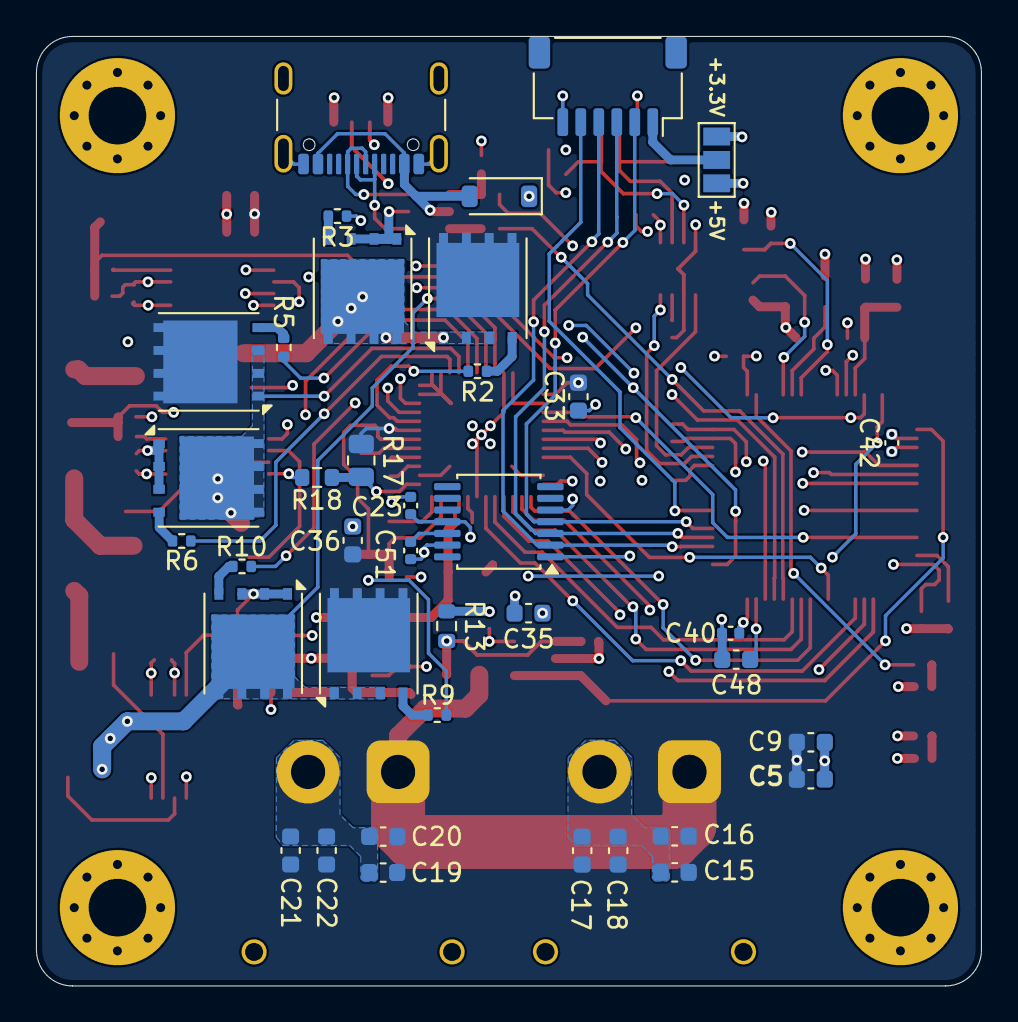
[picture p17: board Phaze.kicad_pcb from below]

Board: 4 copper layers, 52.5 x 52.8 mm, 117 parts (38 on the bottom side), 88 nets.

Other parts of the board:
D5: MBR0530; D_SOD-123
J8: USB_C_Receptacle_USB2.0_16P; USB_C_Receptacle_GCT_USB4105-xx-A_16P_TopMnt_Horizontal
R26: 1k8; R_0402_1005Metric
R27, R28: 100R; R_0402_1005Metric
U9: USBLC6-2SC6; SOT-23-6

Their connections:
+3.3V: R26.1; also elsewhere on the board
+5V: D5.1 (K); also elsewhere on the board
GND: J8.A1 (GND), J8.A12 (GND), J8.B1 (GND), J8.B12 (GND), J8.SH (SHIELD), U9.2 (GND); also elsewhere on the board
unnamed: D5.2 (A), J8.A4 (VBUS), J8.A9 (VBUS), J8.B4 (VBUS), J8.B9 (VBUS), U9.5 (VBUS)
unnamed: J8.A6 (D+), J8.B6 (D+), U9.3 (I/O2)
unnamed: J8.A7 (D-), J8.B7 (D-), U9.1 (I/O1)
unnamed: R26.2, R28.1, U9.4 (I/O2)
unnamed: R27.1, U9.6 (I/O1)
USB_DN: R27.2; also elsewhere on the board
USB_DP: R28.2; also elsewhere on the board
