GoTouchGra55/Phaze/Phaze/Phaze.ioc

Mcu.UserName=STM32F405RGTx
PA0-WKUP.GPIO_Label=I_SENSE_B
PA0-WKUP.Signal=ADCx_IN0
PA10.GPIO_Label=IN_HC
PA10.Signal=S_TIM1_CH3
PA11.Signal=USB_OTG_FS_DM
PA12.Signal=USB_OTG_FS_DP
PA13.Signal=SYS_JTMS-SWDIO
PA14.Signal=SYS_JTCK-SWCLK
PA2.GPIO_Label=I_SENSE_C
PA2.Signal=ADCx_IN2
PA3.GPIO_Label=DCV_SENSE
PA3.Signal=ADCx_IN3
PA5.GPIO_Label=DRV_SCK
PA5.Signal=SPI1_SCK
PA6.GPIO_Label=DRV_MISO
PA6.Signal=SPI1_MISO
PA7.GPIO_Label=DRV_MOSI
PA7.Signal=SPI1_MOSI
PA8.GPIO_Label=IN_HA
PA8.Signal=S_TIM1_CH1
PA9.GPIO_Label=IN_HB
PA9.Signal=S_TIM1_CH2
PB0.GPIO_Label=DRV_CS
PB0.Signal=GPIO_Output
PB10.GPIO_Label=NFAULT
PB10.Signal=GPIO_Output
PB13.GPIO_Label=IN_LA
PB13.Signal=TIM1_CH1N
PB14.GPIO_Label=IN_LB
PB14.Signal=TIM1_CH2N
PB15.GPIO_Label=IN_LC
PB15.Signal=TIM1_CH3N
PB3.GPIO_Label=ENC__CS
PB3.Signal=GPIO_Output
PB8.Signal=CAN1_RX
PB9.Signal=CAN1_TX
PC10.GPIO_Label=ENC_SCK
PC10.Signal=SPI3_SCK
PC11.GPIO_Label=ENC_MISO
PC11.Signal=SPI3_MISO
PC12.GPIO_Label=ENC_MOSI
PC12.Signal=SPI3_MOSI
PC3.GPIO_Label=I_SENSE_A
PC3.Signal=ADCx_IN13
PC8.GPIO_Label=ENABLE
PC8.Signal=GPIO_Output
PH0-OSC_IN.Signal=RCC_OSC_IN
PH1-OSC_OUT.Signal=RCC_OSC_OUT
